watsonboyett/GameTimeClub/hardware/README.md

## Revision History

### Rev. A

* Initial design

### Rev. B

* Added "power good" LED to 3V3 rail
* Removed silkscreen text for part numbers (just not enough room)
* Increased voltage output on 5V step-down converter 
* Added silkscreen text for pin numbers
* Fixed USB A pins (data lines were backwards)
* Added vias to micro USB shield pads to provide better mechanical support
* Added PTC fuse to micro USB port for over-current protection

### Future Changes
