watsonboyett/GameTimeClub/hardware/gametroller.brd

## EAGLE design hardware/gametroller.brd (2019-01-11)

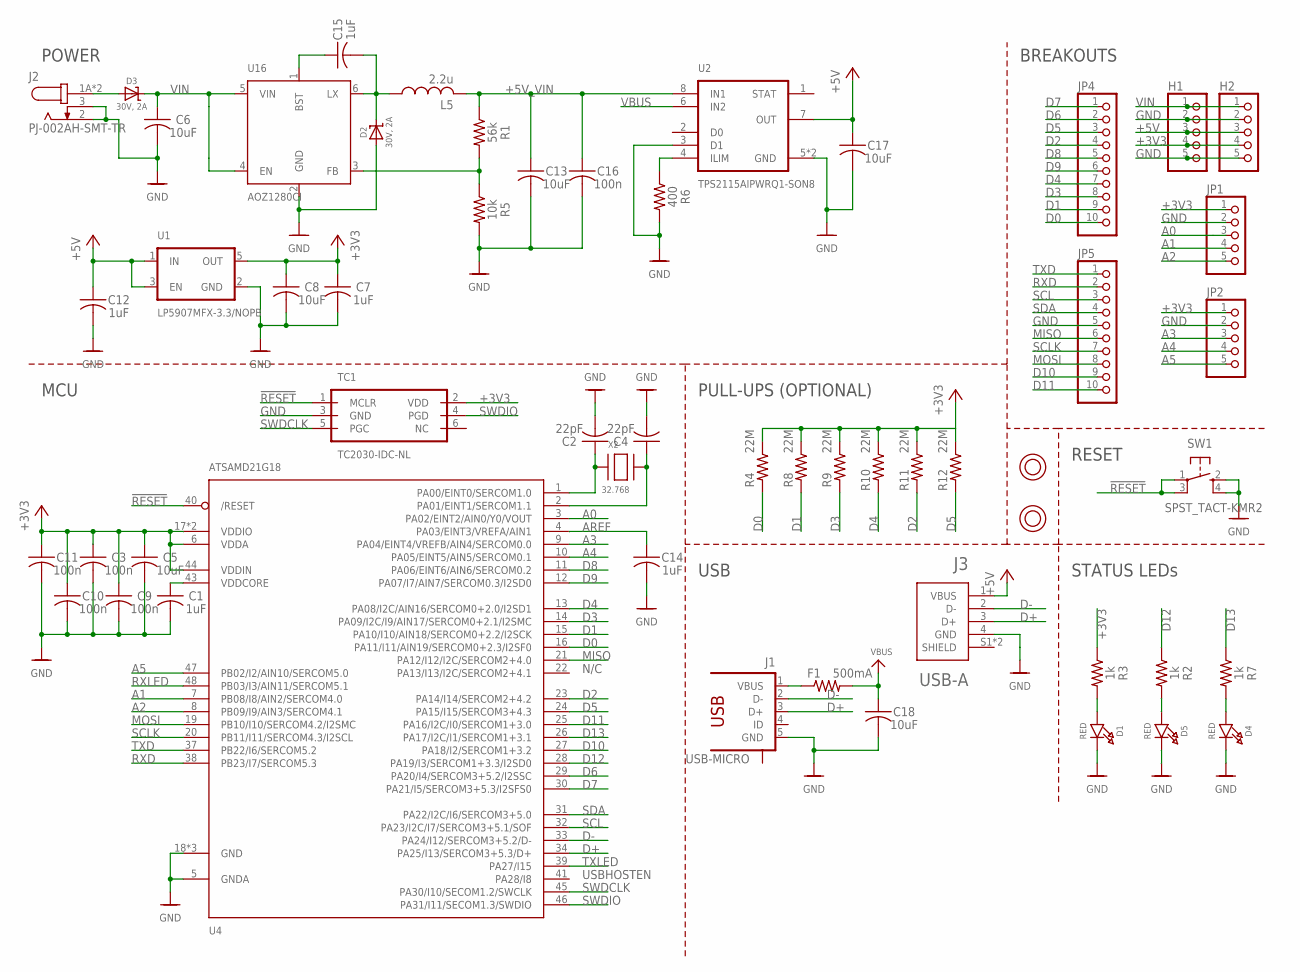
[picture p1: schematic gametroller.sch]

Parts:
C1, C7, C12, C14, C15: 1uF; C0603; MPN 0603ZC105KAT2A
C2, C4: 22pF; C0603; MPN C0603C220K4GACTU
C3, C9, C10, C11, C16: 100n; C0603; MPN C0603X104K5RAC7867
C5, C6, C8, C13, C17, C18: 10uF; C0805; MPN C2012JB1E106K085AC
D1, D4, D5: RED; CHIPLED_0805_NOOUTLINE; MPN LTST-C170GKT
D2, D3: 30V, 2A; SOD-128; MPN CMS06(TE12L,Q,M)
F1: 500mA; R0603; MPN MF-FSMF050X-2
H1, H2: PINHD-1X5-SMT; 1X05-SMT
J1: USB-MICRO; USB-10118192-0001LF
J2: PJ-002AH-SMT-TR; CUI_PJ-002AH-SMT-TR
J3: USB-A; CUI_UJ2-AH-1-SMT
JP1, JP2: PINHD-1X5-SMT; 1X05-SMT
JP4, JP5: PINHD-1X10-SMT; 1X10-SMT
L5: 2.2u; L5050M; MPN TYS50402R2N-10
R1: 56k; R0603; MPN ERJ-3EKF5602V
R2, R3, R7: 1k; R0603; MPN ERJ-3EKF1001V
R4, R8, R9, R10, R11, R12: 22M; R0603; MPN ERJ-3GEYK226V
R5: 10k; R0603; MPN ERJ-3GEYJ103V
R6: 400; R0603; MPN ERJ-3EKF4020V
SW1: SPST_TACT-KMR2; KMR2; MPN KMR211GLFS
TC1: TC2030-IDC-NL
U1: LP5907MFX-3.3/NOPB; SOT95P280X145-5N
U2: TPS2115AIPWRQ1-SON8; SON65P300X300X100-9N
U4: ATSAMD21G18; TQFP48_7MM
U16: AOZ1280CI; SOT-23-6
U$7, U$9: TERM-7774
X2: 32.768; XTAL3215; MPN ECS-.327-12.5-34B-TR

Connections:
!RESET: SW1.1, SW1.3 (P1), TC1.1 (MCLR), U4.40 (/RESET)
+3V3: C3.1, C5.1, C7.1, C8.1, C9.1, C10.1, C11.1, H1.4, H2.4, JP1.1, JP2.1, R3.1, R4.1, R8.1, R9.1, R10.1, R11.1, R12.1, TC1.2 (VDD), U1.5 (OUT), U4.6 (VDDA), U4.17 (VDDIO), U4.36 (VDDIO), U4.44 (VDDIN)
+5V: C12.1, C17.1, H1.3, H2.3, J3.1 (VBUS), U1.1 (IN), U1.3 (EN), U2.7 (OUT)
+5V_VIN: C13.1, C16.1, L5.2, R1.1, U2.8 (IN1)
A0: JP1.3, U4.3 (PA02/EINT2/AIN0/Y0/VOUT)
A1: JP1.4, U4.7 (PB08/I8/AIN2/SERCOM4.0)
A2: JP1.5, U4.8 (PB09/I9/AIN3/SERCOM4.1)
A3: JP2.3, U4.9 (PA04/EINT4/VREFB/AIN4/SERCOM0.0)
A4: JP2.4, U4.10 (PA05/EINT5/AIN5/SERCOM0.1)
A5: JP2.5, U4.47 (PB02/I2/AIN10/SERCOM5.0)
AREF: C14.1, U4.4 (PA03/EINT3/VREFA/AIN1)
D0: JP4.10, R4.2, U4.16 (PA11/I11/AIN19/SERCOM0+2.3/I2SF0)
D1: JP4.9, R8.2, U4.15 (PA10/I10/AIN18/SERCOM0+2.2/I2SCK)
D2: JP4.4, R11.2, U4.23 (PA14/I14/SERCOM2+4.2)
D3: JP4.8, R9.2, U4.14 (PA09/I2C/I9/AIN17/SERCOM0+2.1/I2SMC)
D4: JP4.7, R10.2, U4.13 (PA08/I2C/AIN16/SERCOM0+2.0/I2SD1)
D5: JP4.3, R12.2, U4.24 (PA15/I15/SERCOM3+4.3)
D6: JP4.2, U4.29 (PA20/I4/SERCOM3+5.2/I2SSC)
D7: JP4.1, U4.30 (PA21/I5/SERCOM3+5.3/I2SFS0)
D8: JP4.5, U4.11 (PA06/EINT6/AIN6/SERCOM0.2)
D9: JP4.6, U4.12 (PA07/I7/AIN7/SERCOM0.3/I2SD0)
D10: JP5.9, U4.27 (PA18/I2/SERCOM1+3.2)
D11: JP5.10, U4.25 (PA16/I2C/I0/SERCOM1+3.0)
D12: R2.1, U4.28 (PA19/I3/SERCOM1+3.3/I2SD0)
D13: R7.1, U4.26 (PA17/I2C/I1/SERCOM1+3.1)
D+: J1.3 (D+), J3.3 (D+), U4.34 (PA25/I13/SERCOM3+5.3/D+)
D-: J1.2 (D-), J3.2 (D-), U4.33 (PA24/I12/SERCOM3+5.2/D-)
GND: C1.2, C2.2, C3.2, C4.2, C5.2, C6.2, C7.2, C8.2, C9.2, C10.2, C11.2, C12.2, C13.2, C14.2, C16.2, C17.2, C18.2, D1.C, D2.A, D4.C, D5.C, H1.2, H1.5, H2.2, H2.5, J1.5 (GND), J2.2, J2.3, J3.4 (GND), JP1.2, JP2.2, JP5.5, R5.2, R6.2, SW1.2 (S), SW1.4 (S1), TC1.3 (GND), U1.2 (GND), U2.3 (D1), U2.5 (GND), U2.9 (GND), U4.5 (GNDA), U4.18 (GND), U4.35 (GND), U4.42 (GND), U16.2 (GND)
LX: C15.2, D2.C, L5.1, U16.6 (LX)
MISO: JP5.6, U4.21 (PA12/I12/I2C/SERCOM2+4.0)
MOSI: JP5.8, U4.19 (PB10/I10/SERCOM4.2/I2SMC)
unnamed: D5.A, R2.2
unnamed: D4.A, R7.2
unnamed: D1.A, R3.2
unnamed: F1.1, J1.1 (VBUS)
unnamed: C2.1, U4.1 (PA00/EINT0/SERCOM1.0), X2.P$1
unnamed: C4.1, U4.2 (PA01/EINT1/SERCOM1.1), X2.P$2
unnamed: C15.1, U16.1 (BST)
unnamed: R6.1, U2.4 (ILIM)
unnamed: R1.2, R5.1, U16.3 (FB)
RXD: JP5.2, U4.38 (PB23/I7/SERCOM5.3)
RXLED: U4.48 (PB03/I3/AIN11/SERCOM5.1)
SCL: JP5.3, U4.32 (PA23/I2C/I7/SERCOM3+5.1/SOF)
SCLK: JP5.7, U4.20 (PB11/I11/SERCOM4.3/I2SCL)
SDA: JP5.4, U4.31 (PA22/I2C/I6/SERCOM3+5.0)
SWDCLK: TC1.5 (PGC), U4.45 (PA30/I10/SECOM1.2/SWCLK)
SWDIO: TC1.4 (PGD), U4.46 (PA31/I11/SECOM1.3/SWDIO)
TXD: JP5.1, U4.37 (PB22/I6/SERCOM5.2)
TXLED: U4.39 (PA27/I15)
VBUS: C18.1, F1.2, U2.6 (IN2)
VDDCORE: C1.1, U4.43 (VDDCORE)
VIN: C6.1, D3.C, H1.1, H2.1, U16.4 (EN), U16.5 (VIN)
VIN_PRE: D3.A, J2.1A (1), J2.1B (1)

Notes on the sheet:
POWER
RESET
N/C
USBHOSTEN
BREAKOUTS
STATUS LEDs
MCU
USB
PULL-UPS (OPTIONAL)

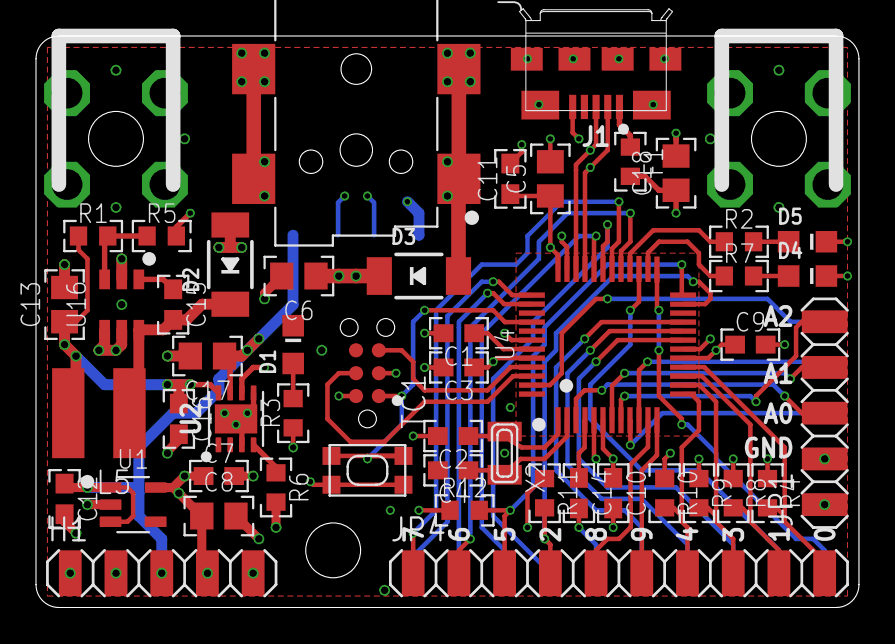
[picture p2: board gametroller.brd from above]

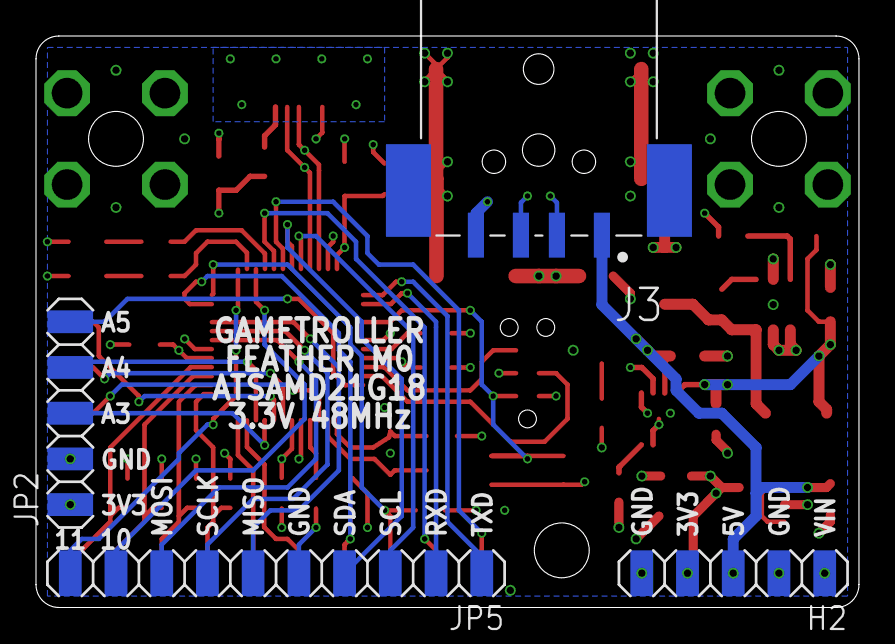
[picture p3: board gametroller.brd from below]

Board: 4 copper layers, 45.7 x 31.8 mm, 58 parts (4 on the bottom side), 51 nets.

Other parts of the board:
U$12, U$13, U$15: HOLE_4-40
