watsonboyett/GameTimeClub/hardware/usbid-switch.brd

## EAGLE design hardware/usbid-switch.brd (2018-10-05)

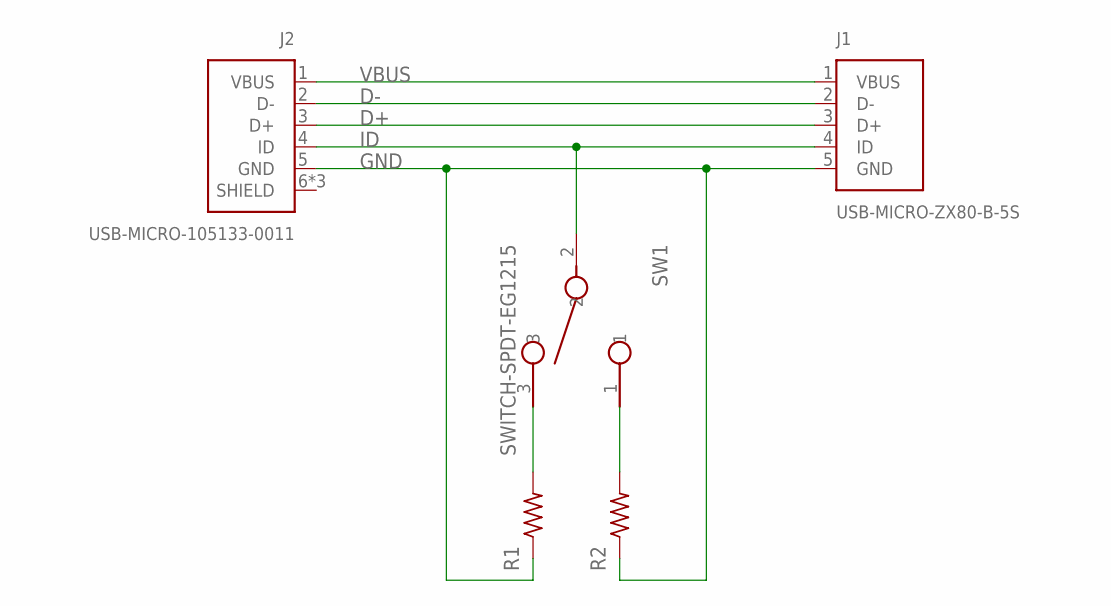
[picture p4: schematic usbid-switch.sch]

Parts:
J1: USB-MICRO-ZX80-B-5S; HRS_ZX80-B-5S
J2: USB-MICRO-105133-0011; MOLEX_105133-0011
R1, R2: R-US_R0603; R0603
SW1: SWITCH-SPDT-EG1215; EG1215

Connections:
D+: J1.3 (D+), J2.3 (D+)
D-: J1.2 (D-), J2.2 (D-)
GND: J1.5 (GND), J2.5 (GND), R1.1, R2.1
ID: J1.4 (ID), J2.4 (ID), SW1.2
unnamed: R1.2, SW1.3
unnamed: R2.2, SW1.1
VBUS: J1.1 (VBUS), J2.1 (VBUS)

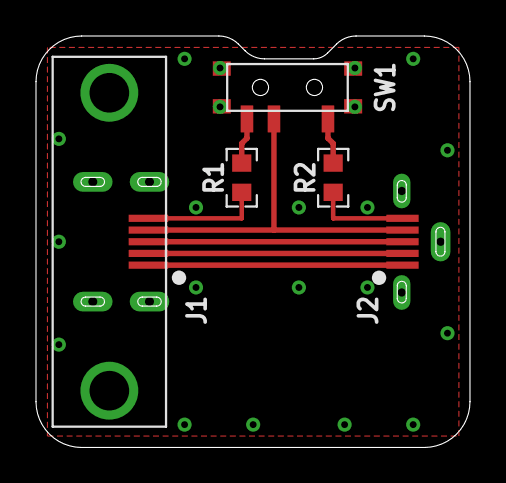
[picture p5: board usbid-switch.brd from above]

Board: 2 copper layers, 24.1 x 22.9 mm, 5 parts (0 on the bottom side), 7 nets.
