watsonboyett/GameTimeClub/(commit log)

2018-08-25 Minor changes to PCB
    * Added "power good" LED to 3V3 rail
    * Removed silkscreen text for part numbers (just not enough room)
    * Increased voltage output on 5V step-down converter
    * Added silkscreen text for pin numbers
    [gametroller.brd, gametroller.sch]
2018-08-25 Added support for start/select buttons and removed Serial console print statements
2018-08-25 Renamed repo and moved files around
    [gametroller.brd, gametroller.sch]
2018-09-22 Added USB-ID selector switch design files
    [gametroller.csv, usbid-switch.brd, usbid-switch.sch]
2018-09-29 Minor modifications and cleanup to PCB
    [gametroller.brd, gametroller.sch]
2018-09-30 Added 22M pullup resistors to several IO pins to allow board to be used as a MaKeyMaKey clone
    [gametroller.brd, gametroller.sch]
2018-10-04 Updated BOM attributes for currently available parts
    [gametroller v1B - BOM.csv, gametroller.brd, gametroller.csv, gametroller.sch, usbid-switch.brd, usbid-switch.sch]
2018-10-05 Fixed some DFM and CAM output issues.
    [usbid-switch.brd, usbid-switch.sch]
2019-01-11 Minor hardware tweaks
    [gametroller.brd, gametroller.sch]
2019-01-11 Changed MaKey clone pins to map to keyboard keys rather than mouse movements
    [gametroller.brd]
