watsonboyett/GameTimeClub/(notices)

Notices in the files:
hardware/gametroller.sch:
CONTACT_PHONE: Licensed under CC-BY-SA
